seniorDesignMAY1607/pcb_HDMI2RGB/README.md

# pcb_HDMI2RGB
KiCad Design files for HDMI to 24Bit RGB converter used to drive DLP3010 TI EVM board.
