seniorDesignMAY1607/pcb_HDMI2RGB/HDMI2RGB_BOM.ods

Reference | Value | Part # | Quantity | Cost | Total | Supplier | Footprint | Link
C1, C15, C16, C17, C18, C19, C2, C22, C24, C29, C3, C30, C31, C34, C35, C4, C5, C6 | 0.1uF | 0402YD104KAT2A | 21 | 0.1 | 2.1 | Mouser | Capacitors_SMD:C_0402 | http://www.mouser.com/ProductDetail/AVX/0402YD104KAT2A/?qs=sGAEpiMZZMs0AnBnWHyRQOGP6fEKn1FCc5icYNsTrcI%3d
C13, C14 | 18pF | 06035A180JAT2A | 2 | 0.1 | 0.2 | Mouser | Capacitors_SMD:C_0603 | http://www.mouser.com/ProductDetail/AVX/06035A180JAT2A/
J1 | HDMI_A | 10029449-111RLF | 1 | 0.73 | 0.73 | Mouser | hdmi:FCI_10029449-11[13]RLF | http://www.mouser.com/ProductDetail/FCI/10029449-111RLF/
SW1 | 2M1-SP1-T2-B4-M6RE | 2M1-SP1-T2-B4-M6RE | 1 |  | 0 |  | misc:2M1-SP1-T2-B4-M6RE
U3 | ABM3B-24.000MHZ-B2-T | ABM3B-24.000MHZ-B2-T | 1 | 1.14 | 1.14 | Mouser | SMD_Packages:XTAL_ABRACON | http://www.mouser.com/ProductDetail/ABRACON/ABM3B-24000MHZ-B2-T/
U5 | ADV7611 | ADV7611BSWZ-P | 1 | 14.21 | 14.21 | Mouser | misc:LQFP-64_TH_10x10mm_Pitch0.5mm | http://www.mouser.com/ProductDetail/Analog-Devices/ADV7611BSWZ-P/?qs=sGAEpiMZZMv9Q1JI0Mo%2ftQPxLbY1tPB%252b
FB1, FB2, FB3, FB4, FB5 | FILTER | BLM18AG601SN1D | 5 | 0.1 | 0.5 | Mouser | Capacitors_SMD:C_0603 | http://www.mouser.com/ProductDetail/Murata-Electronics/BLM18AG601SN1D/?qs=eh6oC%2F9l24oGGaJFkAJJAA%3D%3D
C10, C11, C12, C20, C21, C23, C25, C26, C27, C28, C7, C8, C9 | 10nF | C0402C103K5RACTU | 13 | 0.1 | 1.3 | Mouser | Capacitors_SMD:C_0402 | www.mouser.com/ProductDetail/Kemet/C0402C103K5RACTU/?qs=sGAEpiMZZMs0AnBnWHyRQHHMgvpwHSjWWgw8Y4tWtxo%3d
C36, C37, C40, C41 | 10uF | C0805C106K4PACTU | 4 | 0.29 | 1.16 | Mouser | Capacitors_SMD:C_0805 | http://www.mouser.com/ProductDetail/Kemet/C0805C106K4PACTU/
C38, C39 | 4.7uF | C0805C475K8PACTU | 2 | 0.28 | 0.56 | Mouser | Capacitors_SMD:C_0805 | http://www.mouser.com/ProductDetail/Kemet/C0805C475K8PACTU/?qs=sGAEpiMZZMs0AnBnWHyRQDHs3SeBlWSBNMCXxRDVnHA%3d
R29, R30 | 150k | CRCW0402150KFKED | 2 | 0.1 | 0.2 | Mouser | Resistors_SMD:R_0603 | http://www.mouser.com/ProductDetail/Vishay-Dale/CRCW0402150KFKED/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
R24, R25, R26, R28, R31,R34 | 270 | CRCW0402270RFKED | 6 | 0.1 | 0.6 | Mouser | Resistors_SMD:R_0402 | http://www.mouser.com/ProductDetail/Vishay-Dale/CRCW0402270RFKED/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
R10, R8, R9 | 33 | CRCW040233R0FKED | 3 | 0.1 | 0.3 | Mouser | Capacitors_SMD:C_0402 | http://www.mouser.com/ProductDetail/Vishay-Dale/CRCW040233R0FKED/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
R1, R11, R15, R16, R2, R6 | 0 | CRCW06030000Z0EA | 6 | 0.1 | 0.6 | Mouser | Resistors_SMD:R_0402 | http://www.mouser.com/ProductDetail/Vishay-Dale/CRCW06030000Z0EA/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
R27 | 200 | CRCW0805200RFKEA | 1 | 0.1 | 0.1 | Mouser | Resistors_SMD:R_0805 | http://www.mouser.com/ProductDetail/Vishay-Dale/CRCW0805200RFKEA/
R12, R13, R14, R17, R18, R19, R20, R21, R22, R23, R3, R4, R5, R7 | 4.7k | ERJ-2GEJ472X | 14 | 0.1 | 1.4 | Digikey | Resistors_SMD:R_0402 | http://www.digikey.com/product-detail/en/panasonic-electronic-components/ERJ-2GEJ472X/P4.7KJCT-ND/147025
R33 | 680k | ERJ-2GEJ684X | 1 | 0.1 | 0.1 | Mouser | Resistors_SMD:R_0603 | http://www.mouser.com/ProductDetail/Panasonic/ERJ-2GEJ684X/
R32 | 300k | ERJ-2RKF3003X | 1 | 0.21 | 0.21 | Mouser | Resistors_SMD:R_0603 | http://www.mouser.com/ProductDetail/Panasonic/ERJ-2RKF3003X/
L1, L2 | 2.2uH | LQM31PN2R2M00L | 2 | 0.38 | 0.76 | Mouser | Capacitors_SMD:C_1206 | http://www.mouser.com/ProductDetail/Murata/LQM31PN2R2M00L/
D1, D2, D3, D4, D5, D6 | LED | LTST-C190KGKT | 6 | 0.28 | 1.68 | Mouser | Capacitors_SMD:C_0603 | http://www.mouser.com/ProductDetail/Lite-On/LTST-C190KGKT/
U6 | MSP430F2274TRHAR | MSP430F2274TRHAT | 1 | 6.48 | 6.48 | Mouser | Housings_DFN_QFN:QFN-40-1EP_6x6mm_Pitch0.5mm | http://www.mouser.com/ProductDetail/Texas-Instruments/MSP430F2274TRHAT/
J2 | QTH-030-02-L-DA | QTH-030-L-D-A | 1 | 9.88 | 9.88 | Digikey | QTH_030_02:QTH-030-02-L-D-A | http://www.digikey.com/product-detail/en/samtec-inc/QTH-030-02-L-D-A/SAM8186-ND/1106530
J3 | RAPC712x | RAPC712X | 1 |  | 0 |  | misc:RAPC712
U12, U13, U7, U9 | SN74AUP1G06DCKR | SN74AUP1G06DCKR | 4 |  | 0 |  | TO_SOT_Packages_SMD:SC-70-5
U8 | SN74AUP1G07DCKR | SN74AUP1G07DCKR | 1 |  | 0 |  | TO_SOT_Packages_SMD:SC-70-5
U1, U2 | TPD4S010DQAR | TPD4S010DQAR | 2 | 0.66 | 1.32 | Mouser | misc:10-USON | http://www.mouser.com/ProductDetail/Texas-Instruments/TPD4S010DQAR/
U4 | TPS2061 | TPS2061CDBVT | 1 | 1.48 | 1.48 |  | TO_SOT_Packages_SMD:SOT-23-5 | http://www.mouser.com/ProductDetail/Texas-Instruments/TPS2061CDBVT/
U10, U11 | TPS62260 | TPS62260DRVT | 2 | 1.8 | 3.6 | Mouser | misc:WSON-6 | http://www.mouser.com/ProductDetail/Texas-Instruments/TPS62260DRVT/?qs=sGAEpiMZZMv2US1BCAiByzAvHxVUKNX4
RP1, RP2, RP3 | R_PACK8 | YC248-JR-0733RL | 3 | 0.31 | 0.93 | Mouser | rpack:RPACK-8_0616 | http://www.mouser.com/ProductDetail/Yageo/YC248-JR-0733RL/
H1, H2, H3 | HOLE1 |  | 3 |  | 0 |  | Mounting_Holes:MountingHole_4.3mm_M4_Pad
P1 | CONN_02X07 |  | 1 |  | 0 |  | Connect:IDC_Header_Straight_14pins
P2, P3 | CONN_01X06 |  | 2 |  | 0 |  | Pin_Headers:Pin_Header_Straight_1x06
 |  |  |  |  | 51.54
