seniorDesignMAY1607/pcb_HDMI2RGB/HDMI2RGB.pdf

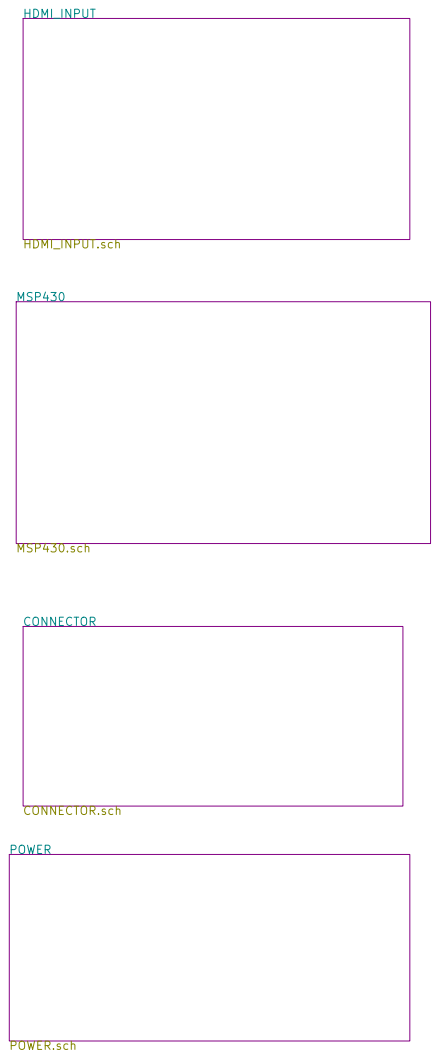
[picture p1: page 1]

IOWA STATE UNIVERSITY - SENIOR DESIGN MAY1607
File: HDMI2RGB.sch Sheet: /
Id: 1/5 Title: PROJECT HIEARCHY

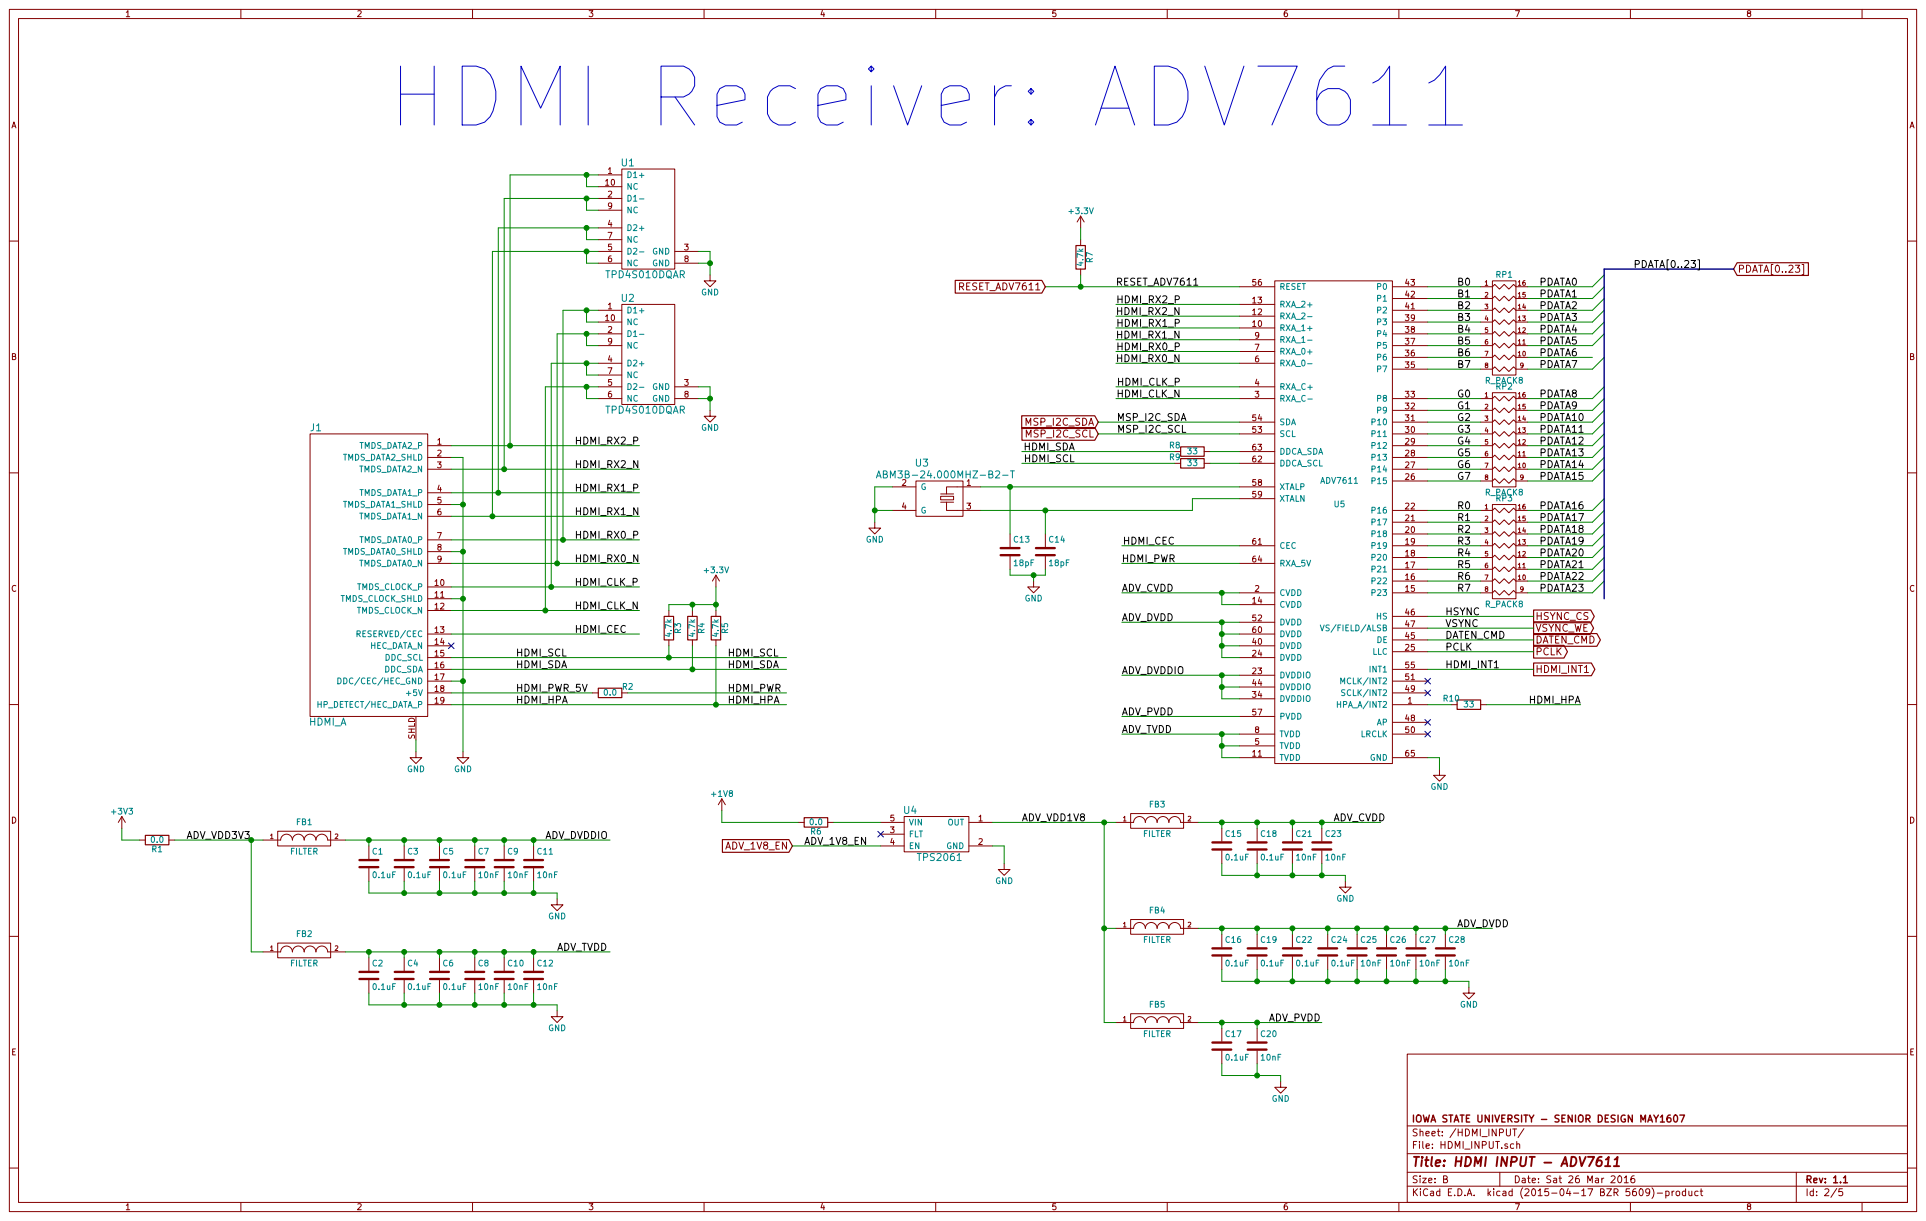
[picture p2: page 2]

HDMI_RX2_N
HDMI_RX1_P
HDMI_RX1_N
HDMI_RX0_P
HDMI_RX0_N

IOWA STATE UNIVERSITY - SENIOR DESIGN MAY1607
Sheet: /HDMI_INPUT/
File: HDMI_INPUT.sch
Id: 2/5 Title: HDMI INPUT - ADV7611

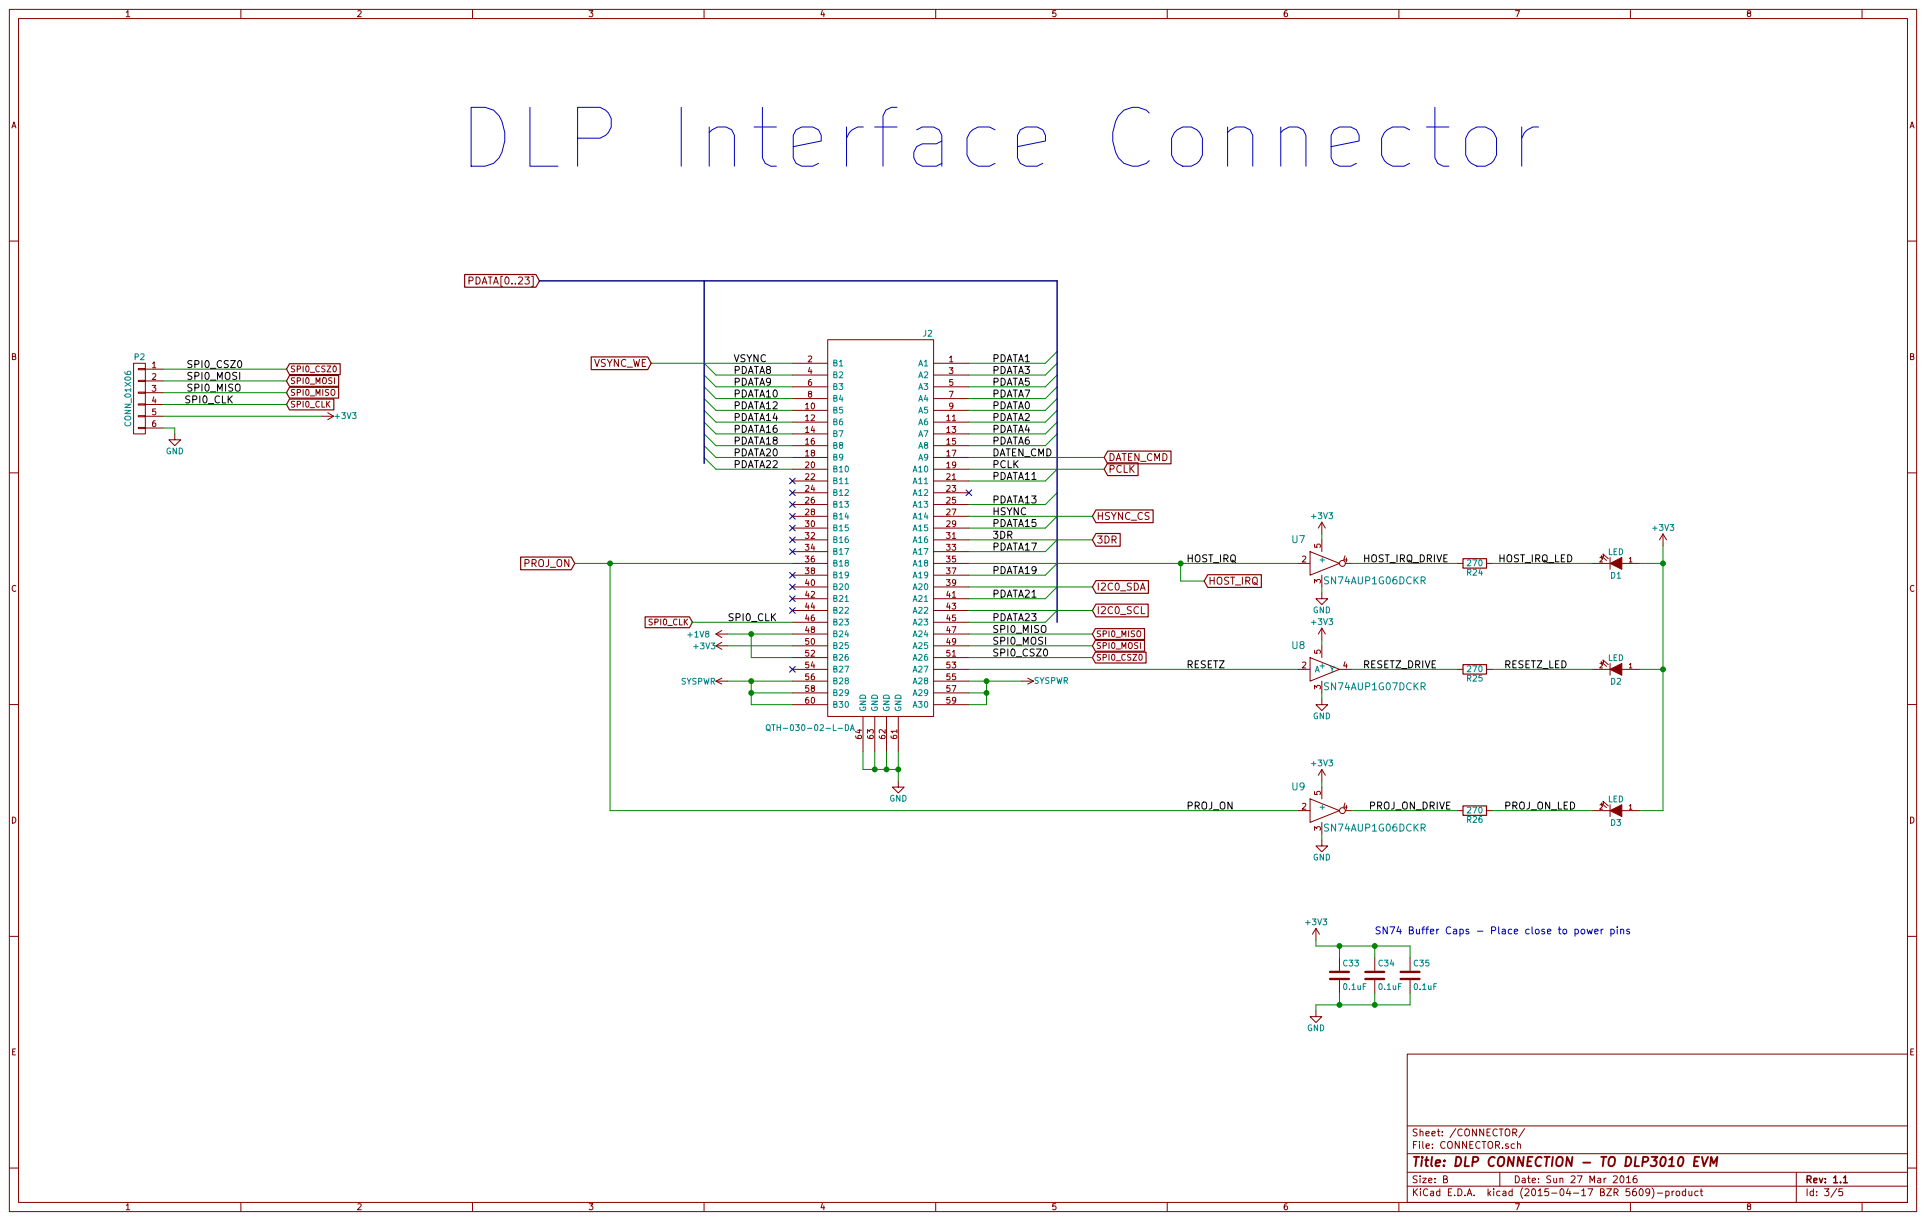
[picture p3: page 3]

0.1uF SN74 Buffer Caps - Place close to power pins

File: CONNECTOR.sch Sheet: /CONNECTOR/
Id: 3/5 Title: DLP CONNECTION - TO DLP3010 EVM

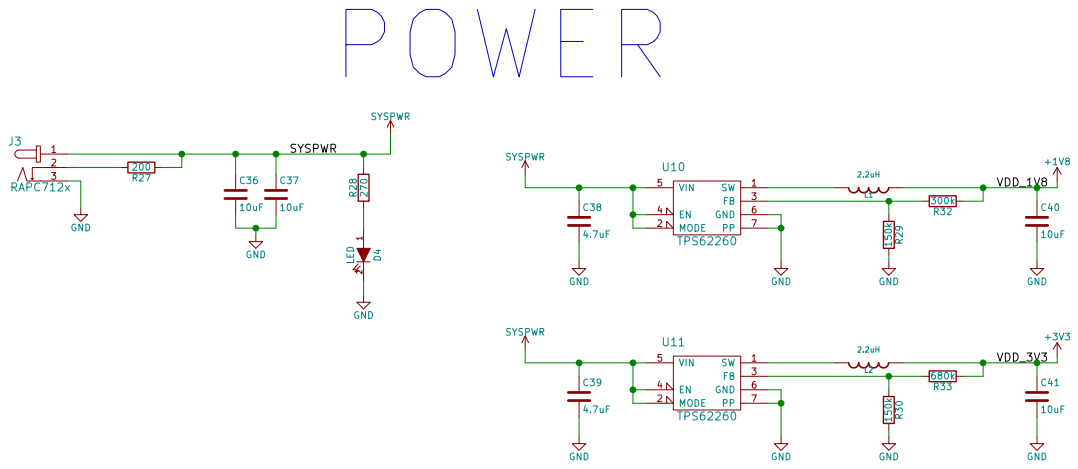
[picture p4: page 4]

Id: 4/5 Title: File: POWER.sch Sheet: /POWER/

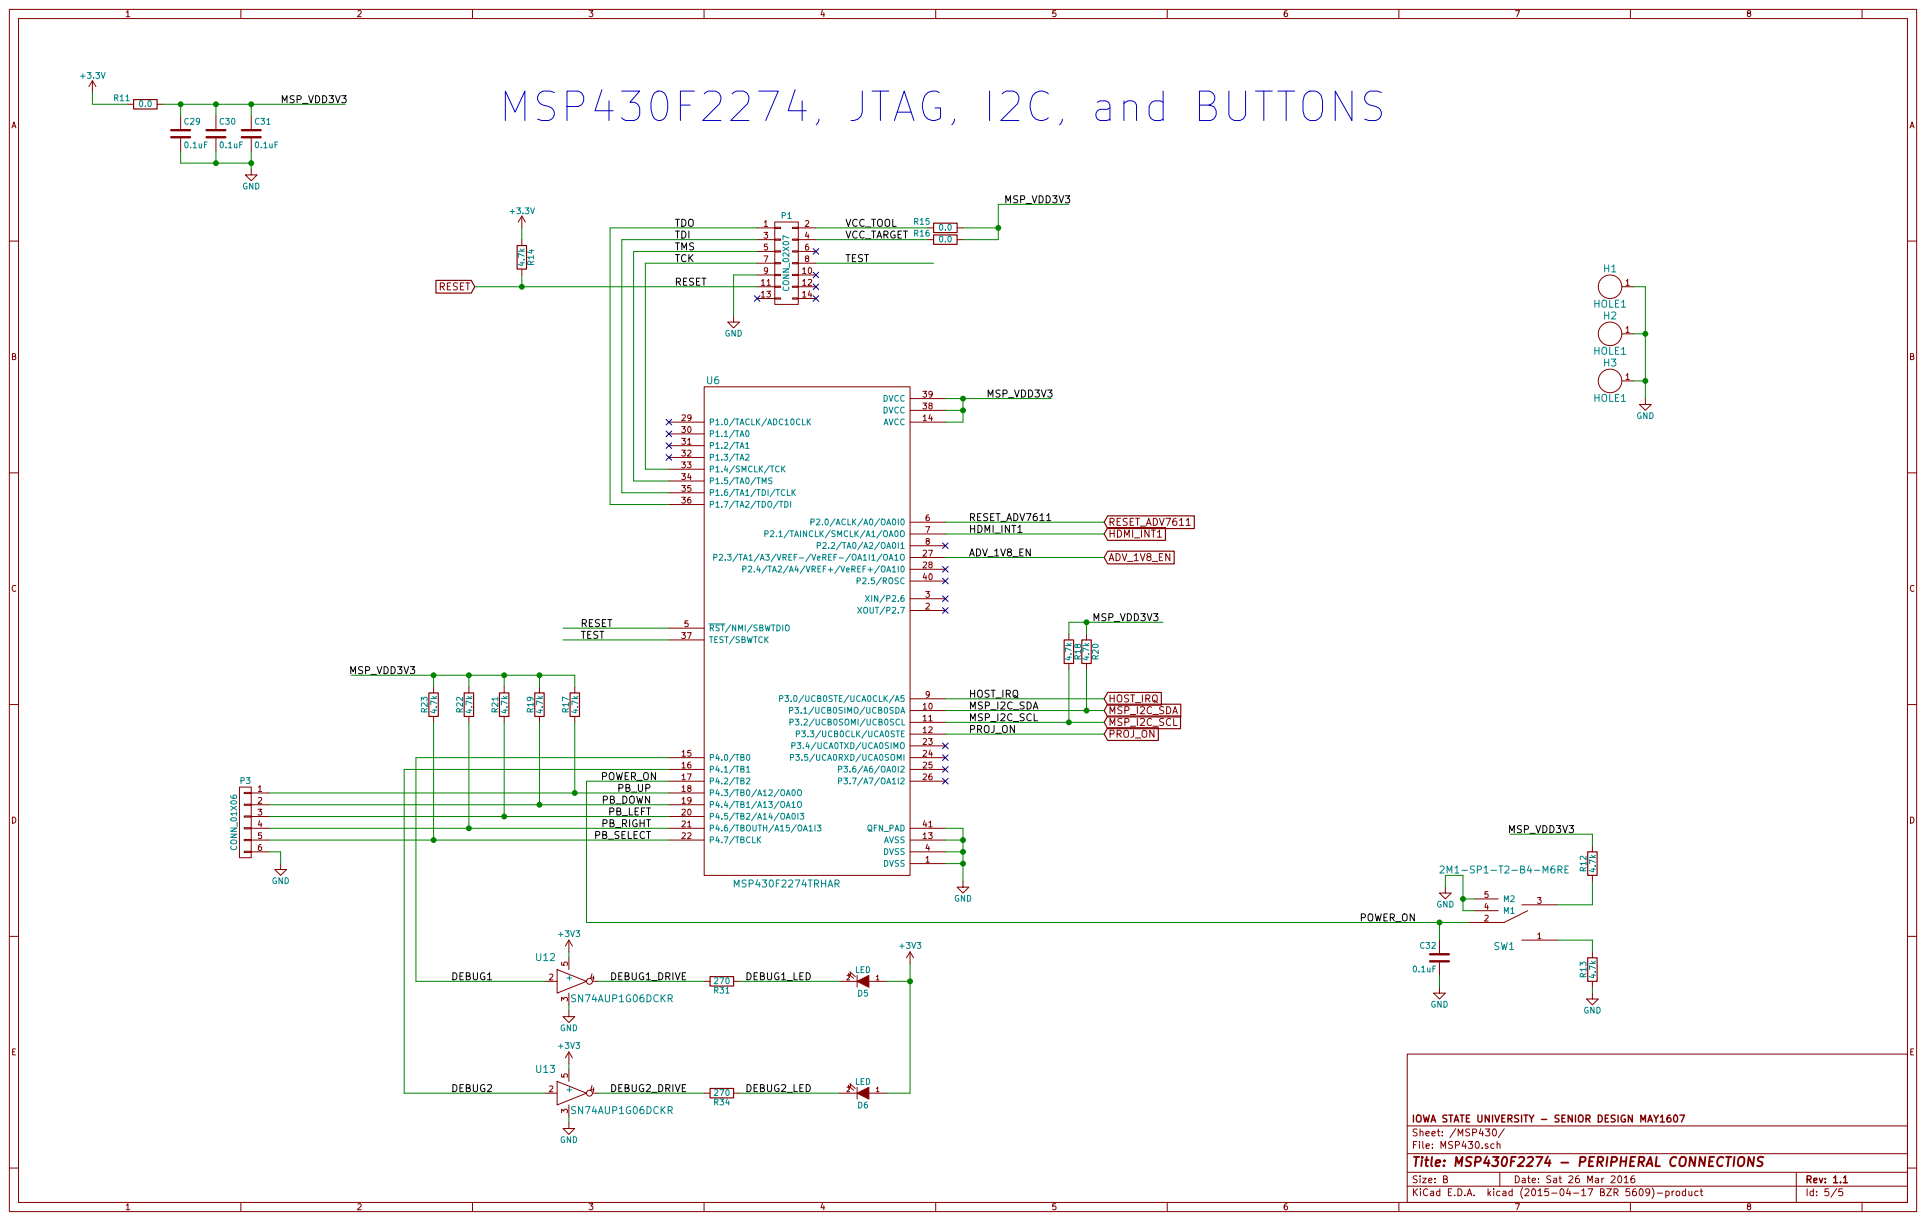
[picture p5: page 5]

2 | | | | PB_DOWN
3 | | | PB_LEFT
4 | | PB_RIGHT
5 | PB_SELECT

IOWA STATE UNIVERSITY - SENIOR DESIGN MAY1607
File: MSP430.sch Sheet: /MSP430/
Id: 5/5 Title: MSP430F2274 - PERIPHERAL CONNECTIONS
