seniorDesignMAY1607/pcb_HDMI2RGB/HDMI2RGB.kicad_pcb

## KiCad design HDMI2RGB.kicad_pcb (2016-03-31)

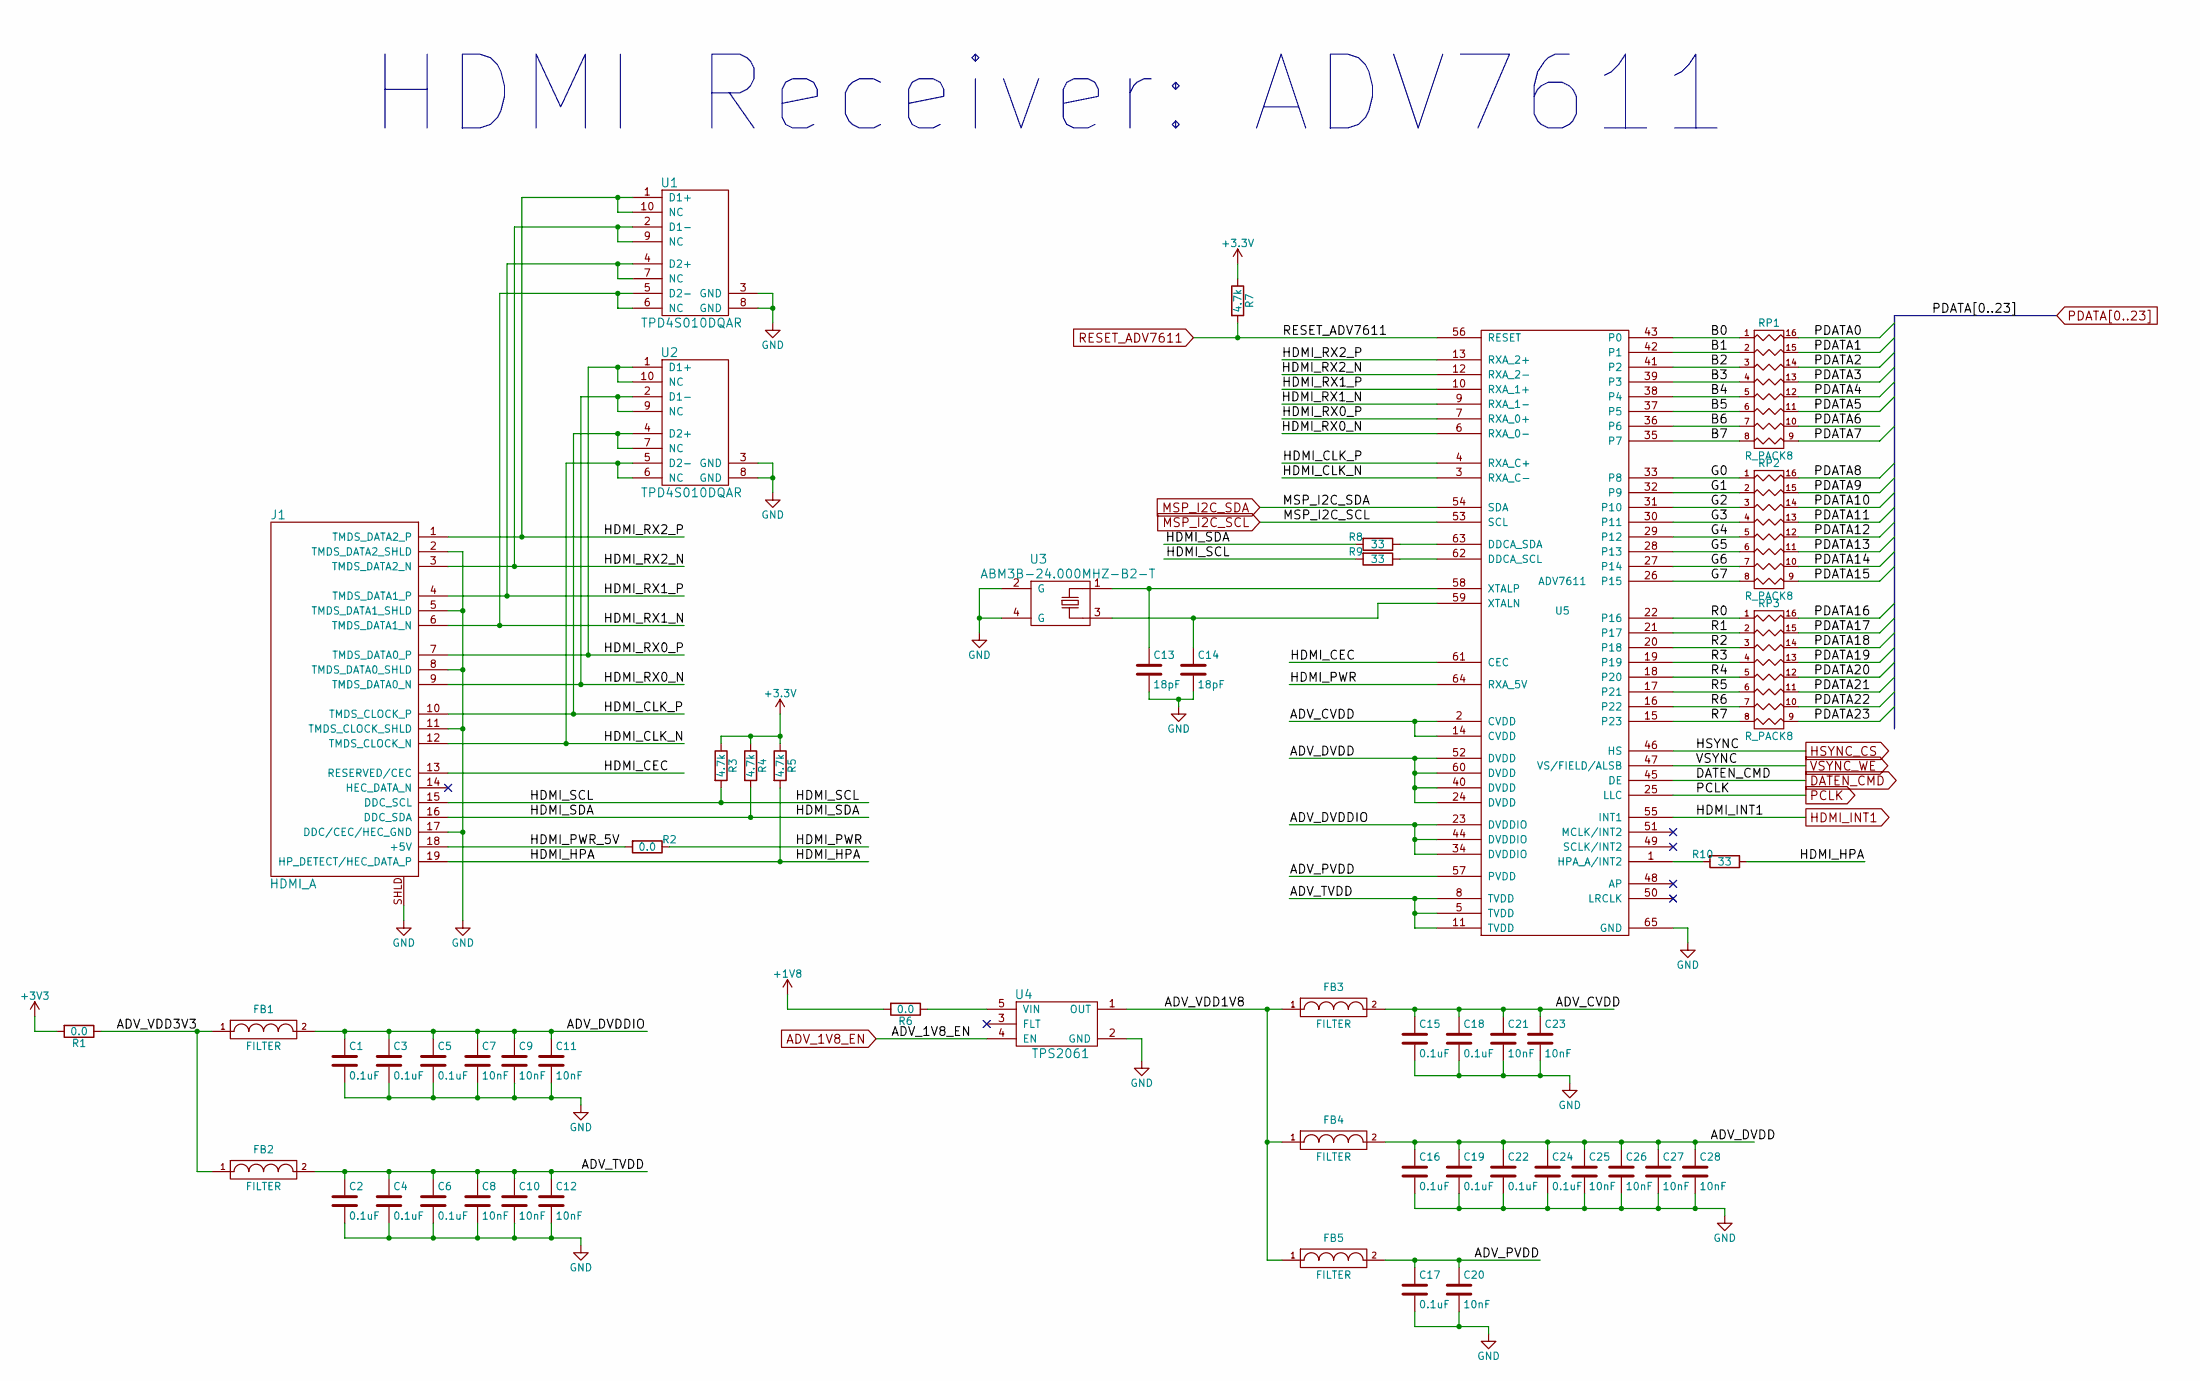
[picture p6: schematic HDMI_INPUT.sch, HDMI INPUT - ADV7611]

Parts:
C1, C2, C3, C4, C5, C6, C15, C16, C17, C18, C19, C22, C24: 0.1uF; C_0402; Part # 0402YD104KAT2A
C7, C8, C9, C10, C11, C12, C20, C21, C23, C25, C26, C27, C28: 10nF; C_0402; Part # C0402C103K5RACTU
C13, C14: 18pF; C_0603; Part # 06035A180JAT2A
FB1, FB2, FB3, FB4, FB5: FILTER; C_0603; Part # BLM18AG601SN1D
J1: HDMI_A; FCI_10029449-11[13]RLF
R1, R2, R6: 0.0; R_0402; Part # CRCW06030000Z0EA
R3, R4, R5, R7: 4.7k; R_0402; Part # ERJ-2GEJ472X
R8, R9: 33; R_0402; Part # CRCW040233R0FKED
R10: 33; C_0402; Part # CRCW040233R0FKED
RP1, RP2, RP3: R_PACK8; RPACK-8_0616
U1, U2: TPD4S010DQAR; 10-USON
U3: ABM3B-24.000MHZ-B2-T; XTAL_ABRACON; Part # ABM3B-24.000MHZ-B2-T
U4: TPS2061; SOT-23-5; Part # TPS2061CDBVT
U5: ADV7611; LQFP-64_TH_10x10mm_Pitch0.5mm

Connections:
+1V8: R6.2; also elsewhere on the board
/CONNECTOR/PDATA0: RP1.16 (R1); also elsewhere on the board
/CONNECTOR/PDATA1: RP1.15 (R2); also elsewhere on the board
/CONNECTOR/PDATA2: RP1.14 (R3); also elsewhere on the board
/CONNECTOR/PDATA3: RP1.13 (R4); also elsewhere on the board
/CONNECTOR/PDATA4: RP1.12 (R5); also elsewhere on the board
/CONNECTOR/PDATA5: RP1.11 (R6); also elsewhere on the board
/CONNECTOR/PDATA6: RP1.10 (R7); also elsewhere on the board
/CONNECTOR/PDATA7: RP1.9 (R8); also elsewhere on the board
/CONNECTOR/PDATA8: RP2.16 (R1); also elsewhere on the board
/CONNECTOR/PDATA9: RP2.15 (R2); also elsewhere on the board
/CONNECTOR/PDATA10: RP2.14 (R3); also elsewhere on the board
/CONNECTOR/PDATA11: RP2.13 (R4); also elsewhere on the board
/CONNECTOR/PDATA12: RP2.12 (R5); also elsewhere on the board
/CONNECTOR/PDATA13: RP2.11 (R6); also elsewhere on the board
/CONNECTOR/PDATA14: RP2.10 (R7); also elsewhere on the board
/CONNECTOR/PDATA15: RP2.9 (R8); also elsewhere on the board
/CONNECTOR/PDATA16: RP3.16 (R1); also elsewhere on the board
/CONNECTOR/PDATA17: RP3.15 (R2); also elsewhere on the board
/CONNECTOR/PDATA18: RP3.14 (R3); also elsewhere on the board
/CONNECTOR/PDATA19: RP3.13 (R4); also elsewhere on the board
/CONNECTOR/PDATA20: RP3.12 (R5); also elsewhere on the board
/CONNECTOR/PDATA21: RP3.11 (R6); also elsewhere on the board
/CONNECTOR/PDATA22: RP3.10 (R7); also elsewhere on the board
/CONNECTOR/PDATA23: RP3.9 (R8); also elsewhere on the board
/HDMI_INPUT/ADV_CVDD: C15.1, C18.1, C21.1, C23.1, FB3.2, U5.2 (CVDD), U5.14 (CVDD)
/HDMI_INPUT/ADV_DVDD: C16.1, C19.1, C22.1, C24.1, C25.1, C26.1, C27.1, C28.1, FB4.2, U5.24 (DVDD), U5.40 (DVDD), U5.52 (DVDD), U5.60 (DVDD)
/HDMI_INPUT/ADV_DVDDIO: C1.1, C3.1, C5.1, C7.1, C9.1, C11.1, FB1.2, U5.23 (DVDDIO), U5.34 (DVDDIO), U5.44 (DVDDIO)
/HDMI_INPUT/ADV_PVDD: C17.1, C20.1, FB5.2, U5.57 (PVDD)
/HDMI_INPUT/ADV_TVDD: C2.1, C4.1, C6.1, C8.1, C10.1, C12.1, FB2.2, U5.5 (TVDD), U5.8 (TVDD), U5.11 (TVDD)
/HDMI_INPUT/ADV_VDD1V8: FB3.1, FB4.1, FB5.1, U4.1 (OUT)
/HDMI_INPUT/ADV_VDD3V3: FB1.1, FB2.1, R1.1
/HDMI_INPUT/B0: RP1.1, U5.43 (P0)
/HDMI_INPUT/B1: RP1.2, U5.42 (P1)
/HDMI_INPUT/B2: RP1.3, U5.41 (P2)
/HDMI_INPUT/B3: RP1.4, U5.39 (P3)
/HDMI_INPUT/B4: RP1.5, U5.38 (P4)
/HDMI_INPUT/B5: RP1.6, U5.37 (P5)
/HDMI_INPUT/B6: RP1.7, U5.36 (P6)
/HDMI_INPUT/B7: RP1.8, U5.35 (P7)
/HDMI_INPUT/G0: RP2.1, U5.33 (P8)
/HDMI_INPUT/G1: RP2.2, U5.32 (P9)
/HDMI_INPUT/G2: RP2.3, U5.31 (P10)
/HDMI_INPUT/G3: RP2.4, U5.30 (P11)
/HDMI_INPUT/G4: RP2.5, U5.29 (P12)
/HDMI_INPUT/G5: RP2.6, U5.28 (P13)
/HDMI_INPUT/G6: RP2.7, U5.27 (P14)
/HDMI_INPUT/G7: RP2.8, U5.26 (P15)
/HDMI_INPUT/HDMI_CEC: J1.13 (RESERVED/CEC), U5.61 (CEC)
/HDMI_INPUT/HDMI_CLK_N: J1.12 (TMDS_CLOCK_N), U2.5 (D2-), U2.6 (NC), U5.3 (RXA_C-)
/HDMI_INPUT/HDMI_CLK_P: J1.10 (TMDS_CLOCK_P), U2.4 (D2+), U2.7 (NC), U5.4 (RXA_C+)
/HDMI_INPUT/HDMI_HPA: J1.19 (HP_DETECT/HEC_DATA_P), R5.2, R10.1
/HDMI_INPUT/HDMI_PWR: R2.1, U5.64 (RXA_5V)
/HDMI_INPUT/HDMI_PWR_5V: J1.18 (+5V), R2.2
/HDMI_INPUT/HDMI_RX0_N: J1.9 (TMDS_DATA0_N), U2.2 (D1-), U2.9 (NC), U5.6 (RXA_0-)
/HDMI_INPUT/HDMI_RX0_P: J1.7 (TMDS_DATA0_P), U2.1 (D1+), U2.10 (NC), U5.7 (RXA_0+)
/HDMI_INPUT/HDMI_RX1_N: J1.6 (TMDS_DATA1_N), U1.5 (D2-), U1.6 (NC), U5.9 (RXA_1-)
/HDMI_INPUT/HDMI_RX1_P: J1.4 (TMDS_DATA1_P), U1.4 (D2+), U1.7 (NC), U5.10 (RXA_1+)
/HDMI_INPUT/HDMI_RX2_N: J1.3 (TMDS_DATA2_N), U1.2 (D1-), U1.9 (NC), U5.12 (RXA_2-)
/HDMI_INPUT/HDMI_RX2_P: J1.1 (TMDS_DATA2_P), U1.1 (D1+), U1.10 (NC), U5.13 (RXA_2+)
/HDMI_INPUT/HDMI_SCL: J1.15 (DDC_SCL), R3.2, R9.2
/HDMI_INPUT/HDMI_SDA: J1.16 (DDC_SDA), R4.2, R8.2
/HDMI_INPUT/R0: RP3.1, U5.22 (P16)
/HDMI_INPUT/R1: RP3.2, U5.21 (P17)
/HDMI_INPUT/R2: RP3.3, U5.20 (P18)
/HDMI_INPUT/R3: RP3.4, U5.19
/HDMI_INPUT/R4: RP3.5, U5.18 (P20)
/HDMI_INPUT/R5: RP3.6, U5.17 (P21)
/HDMI_INPUT/R6: RP3.7, U5.16 (P22)
/HDMI_INPUT/R7: RP3.8, U5.15 (P23)
ADV_1V8_EN: U4.4 (EN); also elsewhere on the board
DATEN_CMD: U5.45 (DE); also elsewhere on the board
GND: C1.2, C2.2, C3.2, C4.2, C5.2, C6.2, C7.2, C8.2, C9.2, C10.2, C11.2, C12.2, C13.2, C14.2, C15.2, C16.2, C17.2, C18.2, C19.2, C20.2, C21.2, C22.2, C23.2, C24.2, C25.2, C26.2, C27.2, C28.2, J1.2 (TMDS_DATA2_SHLD), J1.5 (TMDS_DATA1_SHLD), J1.8 (TMDS_DATA0_SHLD), J1.11 (TMDS_CLOCK_SHLD), J1.17 (DDC/CEC/HEC_GND), J1.SHLD, U1.3 (GND), U1.8 (GND), U2.3 (GND), U2.8 (GND), U3.2 (G), U3.4 (G), U4.2 (GND), U5.65 (GND); also elsewhere on the board
HDMI_INT1: U5.55 (INT1); also elsewhere on the board
HSYNC_CS: U5.46 (HS); also elsewhere on the board
MSP_I2C_SCL: U5.53 (SCL); also elsewhere on the board
MSP_I2C_SDA: U5.54 (SDA); also elsewhere on the board
unnamed: C13.1, U3.1, U5.58 (XTALP)
unnamed: C14.1, U3.3, U5.59 (XTALN)
unnamed: R6.1, U4.5 (VIN)
unnamed: R8.1, U5.63 (DDCA_SDA)
unnamed: R9.1, U5.62 (DDCA_SCL)
unnamed: R10.2, U5.1 (HPA_A/INT2)
PCLK: U5.25 (LLC); also elsewhere on the board
RESET_ADV7611: R7.2, U5.56 (RESET); also elsewhere on the board
VSYNC_WE: U5.47 (VS/FIELD/ALSB); also elsewhere on the board

Notes on the sheet:
HDMI Receiver: ADV7611

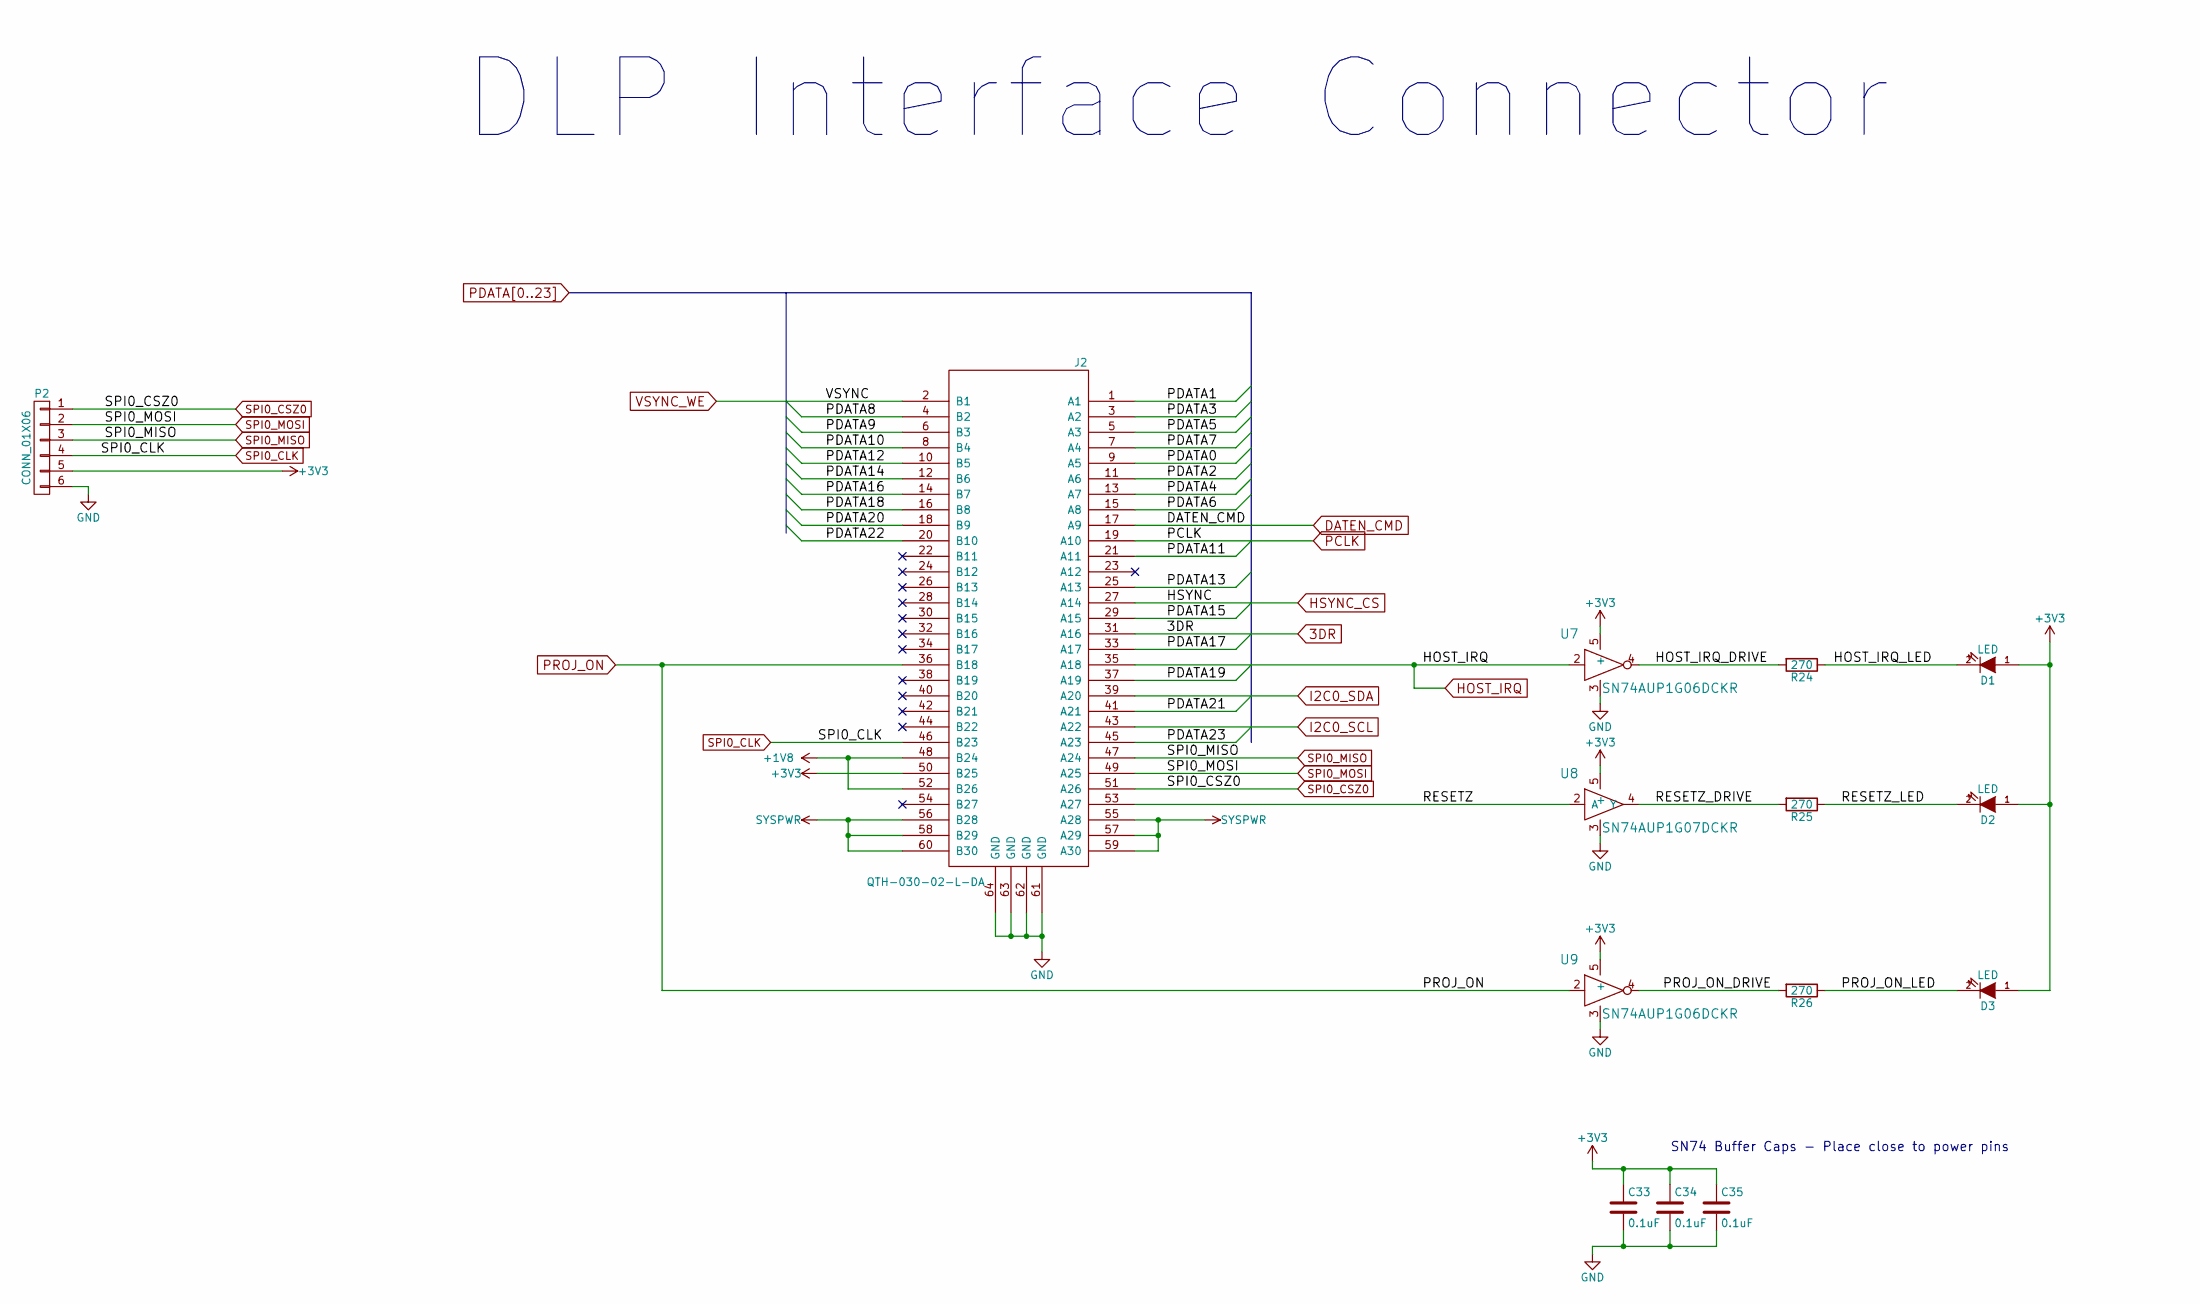
[picture p7: schematic CONNECTOR.sch, DLP CONNECTION - TO DLP3010 EVM]

Parts:
C33, C34, C35: 0.1uF; C_0402; Part # 0402YD104KAT2A
D1, D2, D3: LED; C_0603; Part # LTST-C190KGKT
J2: QTH-030-02-L-DA; QTH-030-02-L-D-A; Part # QTH-030-L-D-A
P2: CONN_01X06; Pin_Header_Straight_1x06
R24, R25, R26: 270; R_0402; Part # CRCW0402270RFKED
U7, U9: SN74AUP1G06DCKR; SC-70-5; Part # SN74AUP1G06DCKR
U8: SN74AUP1G07DCKR; SC-70-5; Part # SN74AUP1G07DCKR

Connections:
3DR: J2.31 (A16)
+1V8: J2.48 (B24), J2.52 (B26); also elsewhere on the board
/CONNECTOR/HOST_IRQ_DRIVE: R24.2, U7.4
/CONNECTOR/HOST_IRQ_LED: D1.2 (K), R24.1
/CONNECTOR/PDATA0: J2.9 (A5); also elsewhere on the board
/CONNECTOR/PDATA1: J2.1 (A1); also elsewhere on the board
/CONNECTOR/PDATA2: J2.11 (A6); also elsewhere on the board
/CONNECTOR/PDATA3: J2.3 (A2); also elsewhere on the board
/CONNECTOR/PDATA4: J2.13 (A7); also elsewhere on the board
/CONNECTOR/PDATA5: J2.5 (A3); also elsewhere on the board
/CONNECTOR/PDATA6: J2.15 (A8); also elsewhere on the board
/CONNECTOR/PDATA7: J2.7 (A4); also elsewhere on the board
/CONNECTOR/PDATA8: J2.4 (B2); also elsewhere on the board
/CONNECTOR/PDATA9: J2.6 (B3); also elsewhere on the board
/CONNECTOR/PDATA10: J2.8 (B4); also elsewhere on the board
/CONNECTOR/PDATA11: J2.21 (A11); also elsewhere on the board
/CONNECTOR/PDATA12: J2.10 (B5); also elsewhere on the board
/CONNECTOR/PDATA13: J2.25 (A13); also elsewhere on the board
/CONNECTOR/PDATA14: J2.12 (B6); also elsewhere on the board
/CONNECTOR/PDATA15: J2.29 (A15); also elsewhere on the board
/CONNECTOR/PDATA16: J2.14 (B7); also elsewhere on the board
/CONNECTOR/PDATA17: J2.33 (A17); also elsewhere on the board
/CONNECTOR/PDATA18: J2.16 (B8); also elsewhere on the board
/CONNECTOR/PDATA19: J2.37 (A19); also elsewhere on the board
/CONNECTOR/PDATA20: J2.18 (B9); also elsewhere on the board
/CONNECTOR/PDATA21: J2.41 (A21); also elsewhere on the board
/CONNECTOR/PDATA22: J2.20 (B10); also elsewhere on the board
/CONNECTOR/PDATA23: J2.45 (A23); also elsewhere on the board
/CONNECTOR/PROJ_ON_DRIVE: R26.2, U9.4
/CONNECTOR/PROJ_ON_LED: D3.2 (K), R26.1
/CONNECTOR/RESETZ: J2.53 (A27), U8.2 (A)
/CONNECTOR/RESETZ_DRIVE: R25.2, U8.4 (Y)
/CONNECTOR/RESETZ_LED: D2.2 (K), R25.1
DATEN_CMD: J2.17 (A9); also elsewhere on the board
GND: C33.2, C34.2, C35.2, J2.61 (GND), J2.62 (GND), J2.63 (GND), J2.64 (GND), P2.6, U7.3, U8.3, U9.3; also elsewhere on the board
HOST_IRQ: J2.35 (A18), U7.2; also elsewhere on the board
HSYNC_CS: J2.27 (A14); also elsewhere on the board
I2C0_SCL: J2.43 (A22)
I2C0_SDA: J2.39 (A20)
PCLK: J2.19 (A10); also elsewhere on the board
PROJ_ON: J2.36 (B18), U9.2; also elsewhere on the board
SPI0_CLK: J2.46 (B23), P2.4
SPI0_CSZ0: J2.51 (A26), P2.1
SPI0_MISO: J2.47 (A24), P2.3
SPI0_MOSI: J2.49 (A25), P2.2
SYSPWR: J2.55 (A28), J2.56 (B28), J2.57 (A29), J2.58 (B29), J2.59 (A30), J2.60 (B30); also elsewhere on the board
VSYNC_WE: J2.2 (B1); also elsewhere on the board

Notes on the sheet:
SN74 Buffer Caps - Place close to power pins
DLP Interface Connector

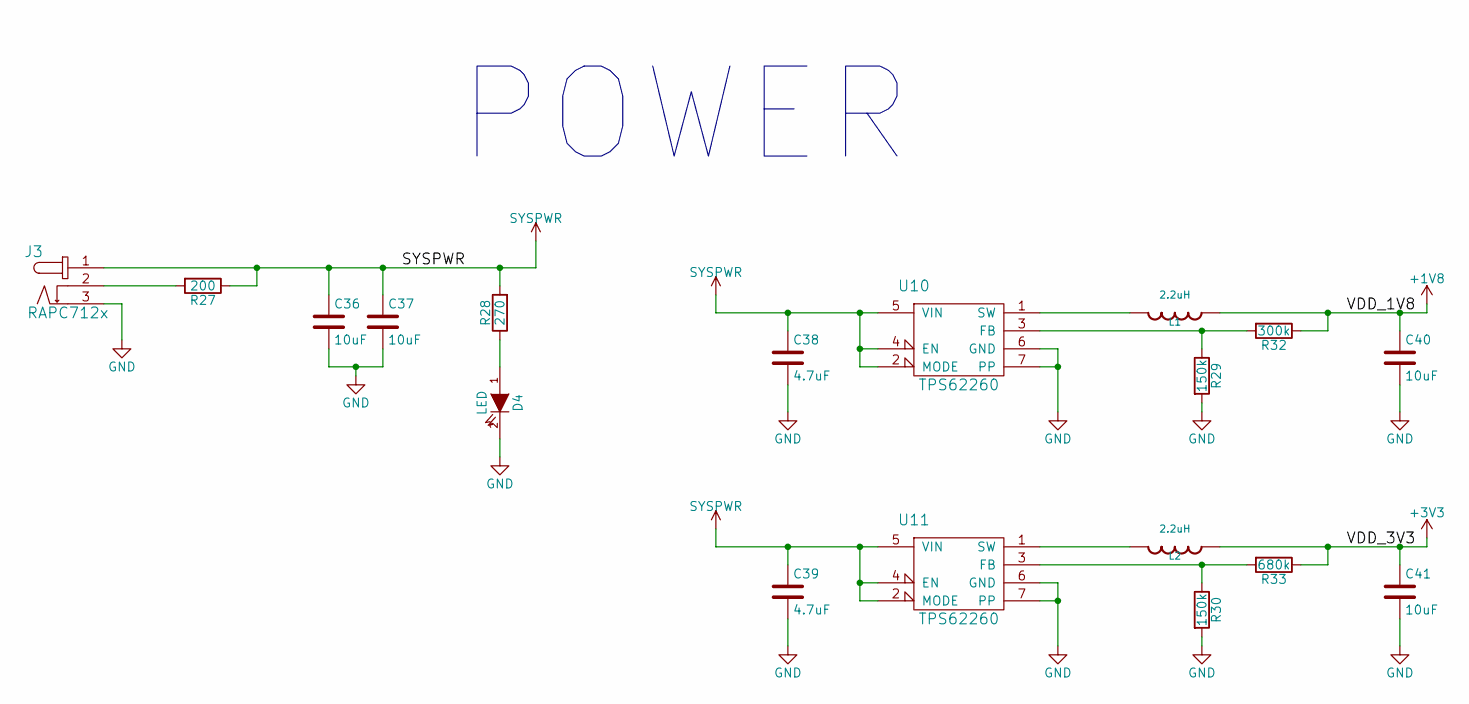
[picture p8: schematic POWER.sch]

Parts:
C36, C37, C40, C41: 10uF; C_0805; Part # C0805C106K4PACTU
C38, C39: 4.7uF; C_0805; Part # C0805C475K8PACTU
D4: LED; C_0603; Part # LTST-C190KGKT
J3: RAPC712x; RAPC712; Part # RAPC712X
L1, L2: 2.2uH; C_1206; Part # LQM31PN2R2M00L
R27: 200; R_0805; Part # CRCW0805200RFKEA
R28: 270; R_0603; Part # CRCW0402270RFKED
R29, R30: 150k; R_0603; Part # CRCW0402150KFKED
R32: 300k; R_0603; Part # ERJ-2RKF3003X
R33: 680k; R_0603; Part # ERJ-2GEJ684X
U10, U11: TPS62260; WSON-6; Part # TPS62260DRVT

Connections:
+1V8: C40.1, L1.2, R32.1; also elsewhere on the board
GND: C36.2, C37.2, C38.2, C39.2, C40.2, C41.2, D4.2 (K), J3.3, R29.2, R30.2, U10.6 (GND), U10.7 (PP), U11.6 (GND), U11.7 (PP); also elsewhere on the board
unnamed: D4.1 (A), R28.1
unnamed: J3.2, R27.2
unnamed: L1.1, U10.1 (SW)
unnamed: L2.1, U11.1 (SW)
unnamed: R29.1, R32.2, U10.3 (FB)
unnamed: R30.1, R33.2, U11.3 (FB)
SYSPWR: C36.1, C37.1, C38.1, C39.1, J3.1, R27.1, R28.2, U10.2 (MODE), U10.4 (EN), U10.5 (VIN), U11.2 (MODE), U11.4 (EN), U11.5 (VIN); also elsewhere on the board

Notes on the sheet:
POWER

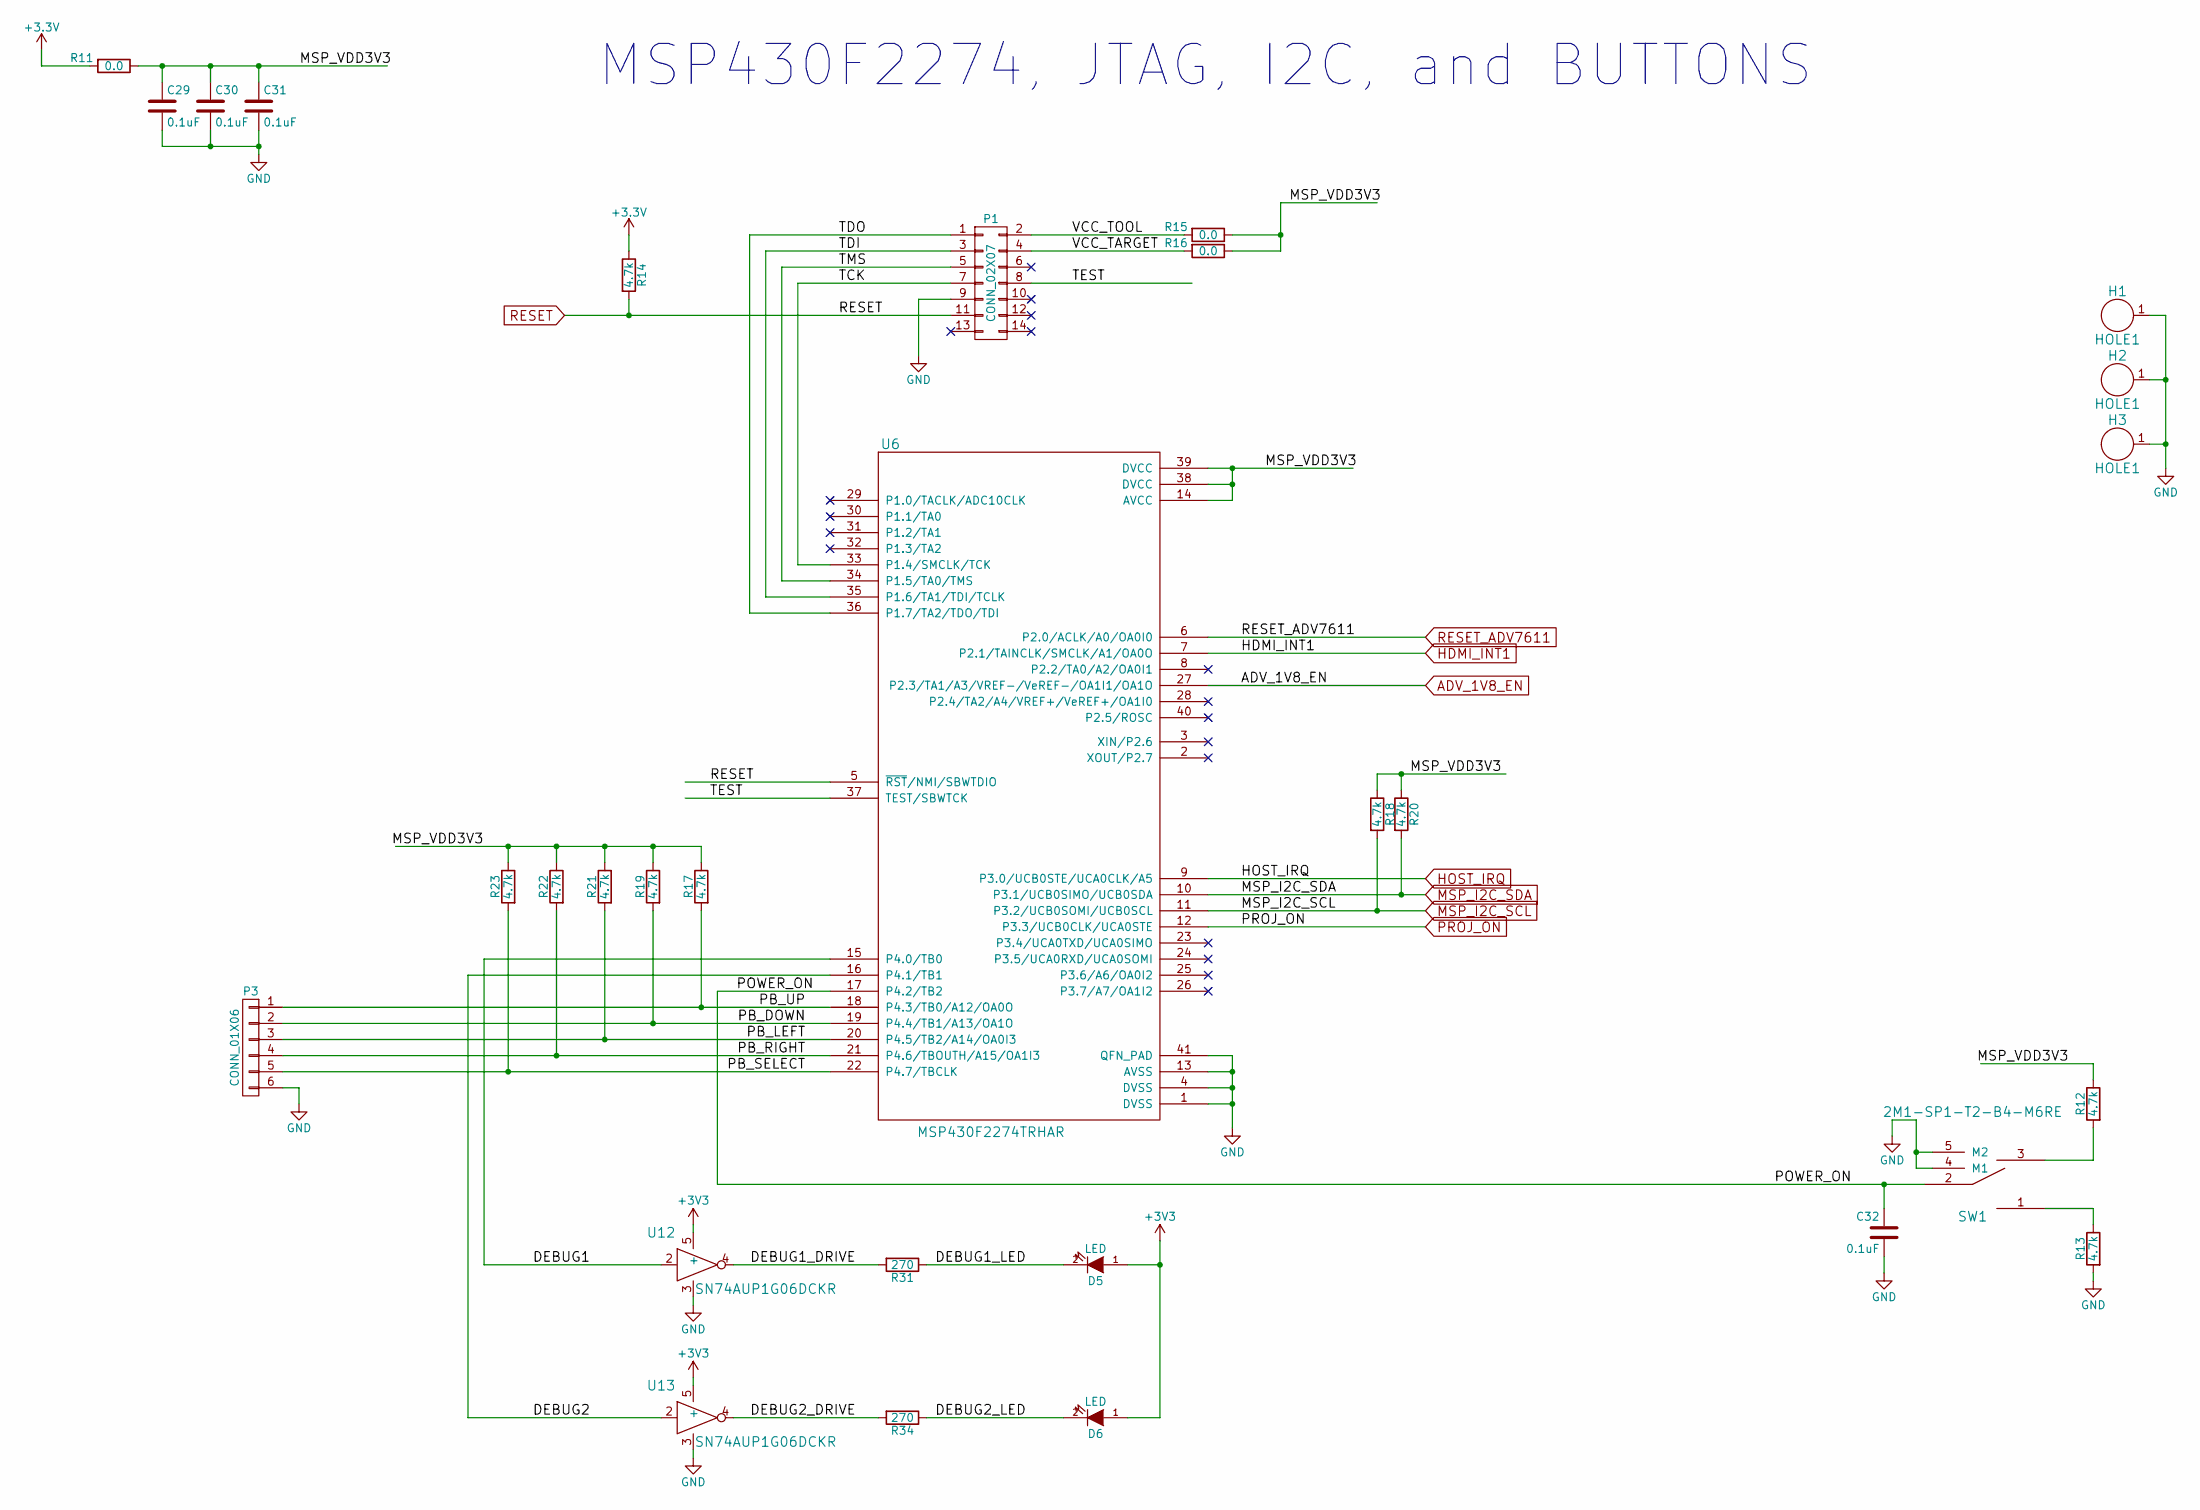
[picture p9: schematic MSP430.sch, MSP430F2274 - PERIPHERAL CONNECTIONS]

Parts:
C29, C30, C31, C32: 0.1uF; C_0402; Part # 0402YD104KAT2A
D5, D6: LED; C_0603; Part # LTST-C190KGKT
H1, H2, H3: HOLE1; MountingHole_4.3mm_M4_Pad
P1: CONN_02X07; IDC_Header_Straight_14pins
P3: CONN_01X06; Pin_Header_Straight_1x06
R11, R15, R16: 0.0; R_0402; Part # CRCW06030000Z0EA
R12, R13, R14, R17, R18, R19, R20, R21, R22, R23: 4.7k; R_0402; Part # ERJ-2GEJ472X
R31, R34: 270; R_0402; Part # CRCW0402270RFKED
SW1: 2M1-SP1-T2-B4-M6RE; Part # 2M1-SP1-T2-B4-M6RE
U6: MSP430F2274TRHAR; QFN-40-1EP_6x6mm_Pitch0.5mm
U12, U13: SN74AUP1G06DCKR; SC-70-5; Part # SN74AUP1G06DCKR

Connections:
/MSP430/DEBUG1: U6.15 (P4.0/TB0), U12.2
/MSP430/DEBUG1_DRIVE: R31.2, U12.4
/MSP430/DEBUG1_LED: D5.2 (K), R31.1
/MSP430/DEBUG2: U6.16 (P4.1/TB1), U13.2
/MSP430/DEBUG2_DRIVE: R34.2, U13.4
/MSP430/DEBUG2_LED: D6.2 (K), R34.1
/MSP430/MSP_VDD3V3: C29.1, C30.1, C31.1, R11.1, R12.1, R15.1, R16.1, R17.1, R18.1, R19.1, R20.1, R21.1, R22.1, R23.1, U6.14 (AVCC), U6.38 (DVCC), U6.39 (DVCC)
/MSP430/PB_DOWN: P3.2, R19.2, U6.19 (P4.4/TB1/A13/OA1O)
/MSP430/PB_LEFT: P3.3, R21.2, U6.20 (P4.5/TB2/A14/OA0I3)
/MSP430/PB_RIGHT: P3.4, R22.2, U6.21 (P4.6/TBOUTH/A15/OA1I3)
/MSP430/PB_SELECT: P3.5, R23.2, U6.22 (P4.7/TBCLK)
/MSP430/PB_UP: P3.1, R17.2, U6.18 (P4.3/TB0/A12/OA0O)
/MSP430/POWER_ON: C32.1, SW1.2, U6.17 (P4.2/TB2)
/MSP430/TCK: P1.7, U6.33 (P1.4/SMCLK/TCK)
/MSP430/TDI: P1.3, U6.35 (P1.6/TA1/TDI/TCLK)
/MSP430/TDO: P1.1, U6.36 (P1.7/TA2/TDO/TDI)
/MSP430/TEST: P1.8, U6.37 (TEST/SBWTCK)
/MSP430/TMS: P1.5, U6.34 (P1.5/TA0/TMS)
/MSP430/VCC_TARGET: P1.4, R16.2
/MSP430/VCC_TOOL: P1.2, R15.2
ADV_1V8_EN: U6.27 (P2.3/TA1/A3/VREF-/VeREF-/OA1I1/OA1O); also elsewhere on the board
GND: C29.2, C30.2, C31.2, C32.2, H1.1, H2.1, H3.1, P1.9, P3.6, R13.2, SW1.4 (M1), SW1.5 (M2), U6.1 (DVSS), U6.4 (DVSS), U6.13 (AVSS), U6.41 (QFN_PAD), U12.3, U13.3; also elsewhere on the board
HDMI_INT1: U6.7 (P2.1/TAINCLK/SMCLK/A1/OA0O); also elsewhere on the board
HOST_IRQ: U6.9 (P3.0/UCB0STE/UCA0CLK/A5); also elsewhere on the board
MSP_I2C_SCL: R18.2, U6.11 (P3.2/UCB0SOMI/UCB0SCL); also elsewhere on the board
MSP_I2C_SDA: R20.2, U6.10 (P3.1/UCB0SIMO/UCB0SDA); also elsewhere on the board
unnamed: R12.2, SW1.3
unnamed: R13.1, SW1.1
PROJ_ON: U6.12 (P3.3/UCB0CLK/UCA0STE); also elsewhere on the board
RESET: P1.11, R14.2, U6.5 (~RST~/NMI/SBWTDIO)
RESET_ADV7611: U6.6 (P2.0/ACLK/A0/OA0I0); also elsewhere on the board

Notes on the sheet:
MSP430F2274, JTAG, I2C, and BUTTONS

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
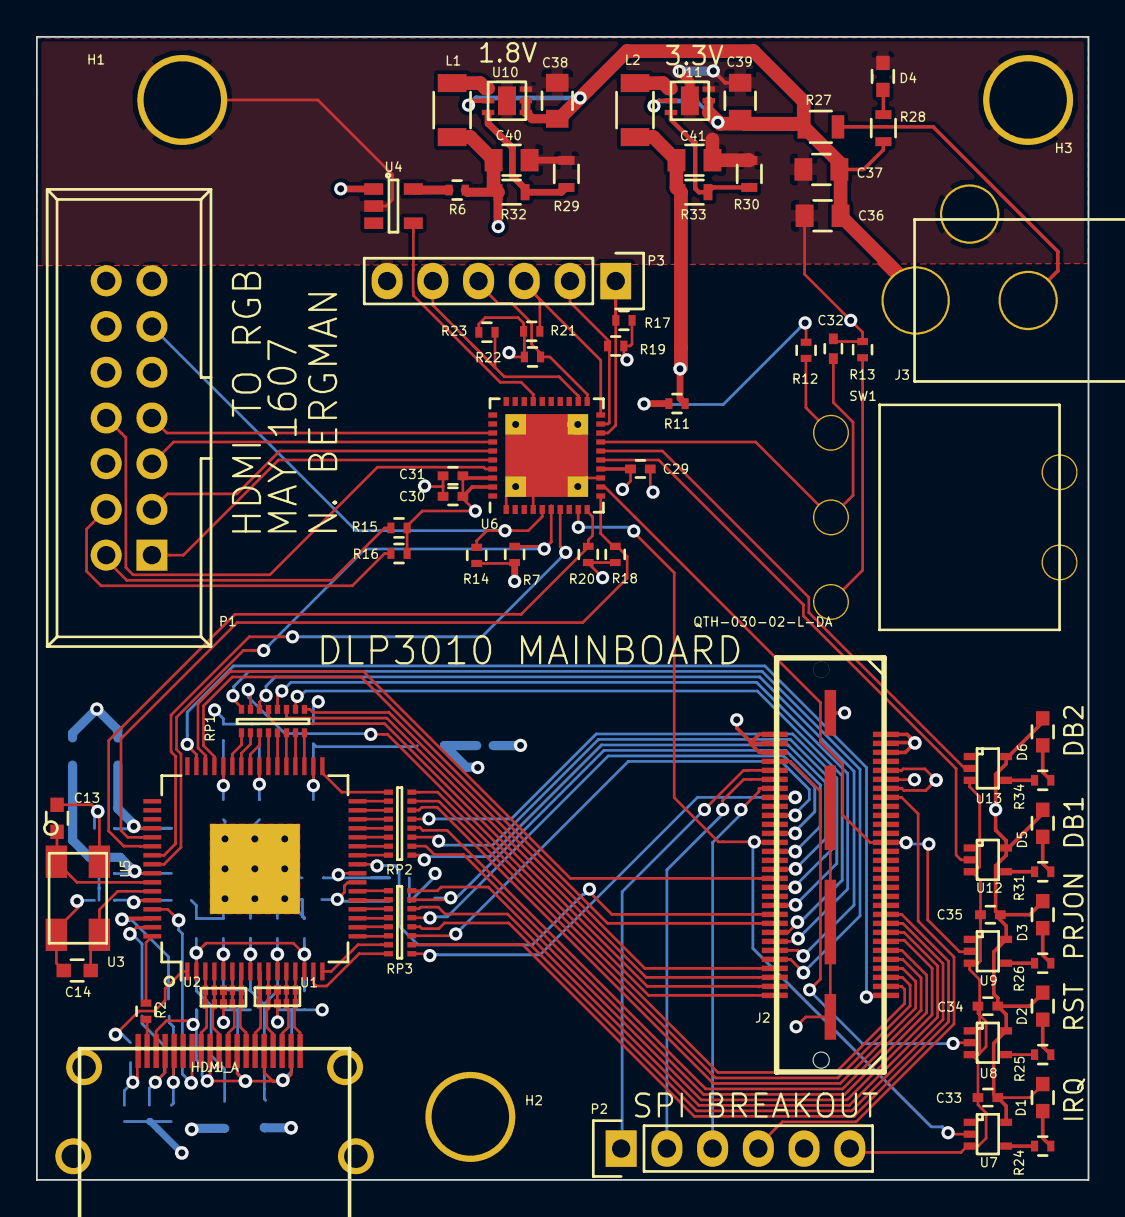
[picture p10: board HDMI2RGB.kicad_pcb from above]

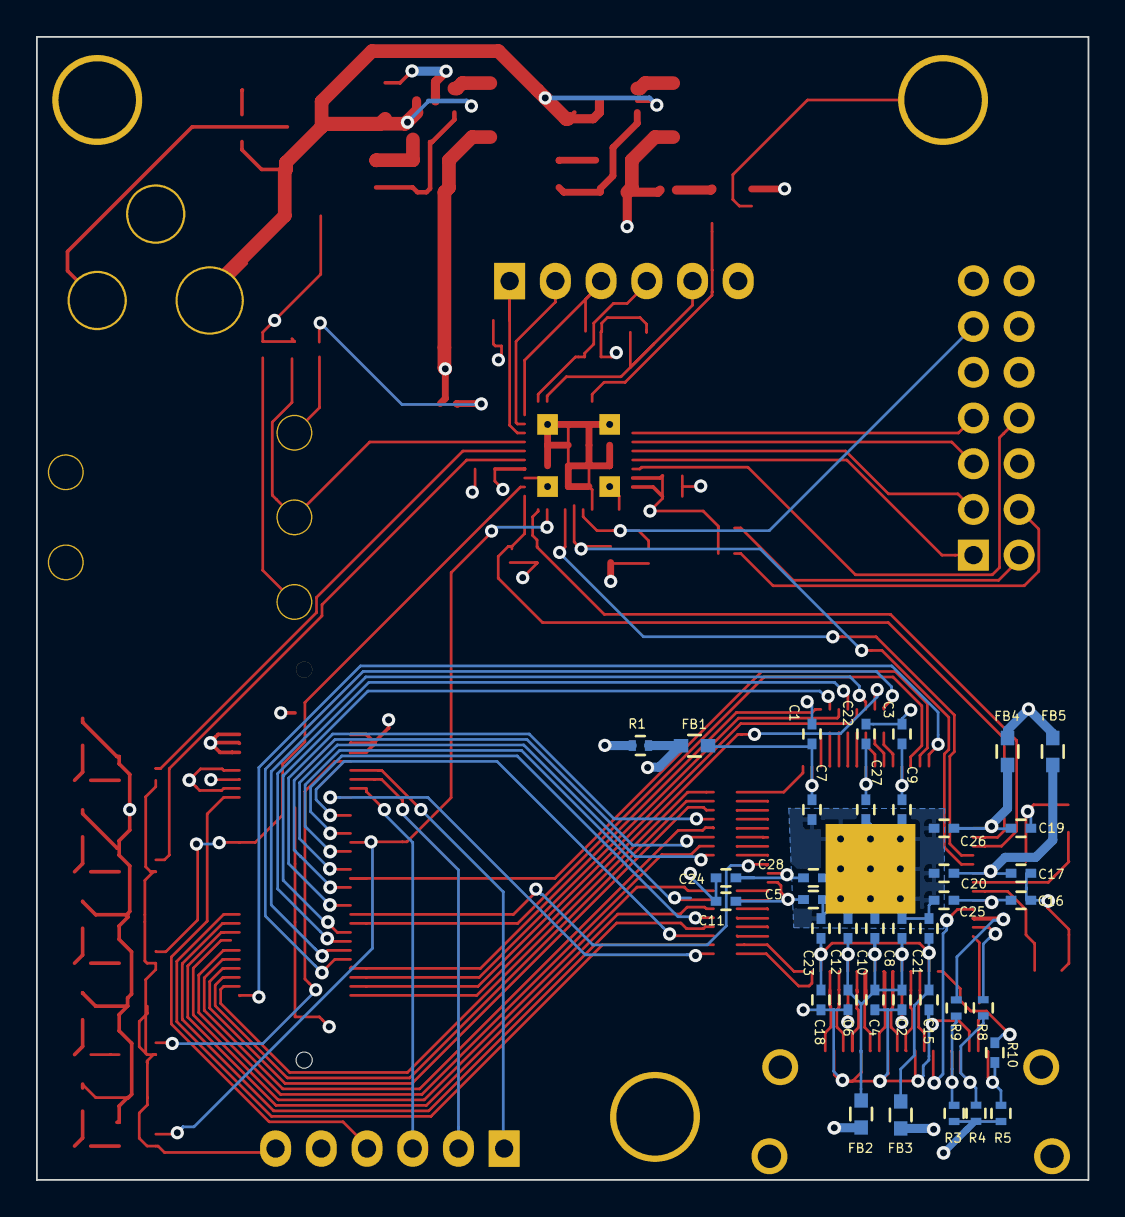
[picture p11: board HDMI2RGB.kicad_pcb from below]

Board: 4 copper layers, 58.4 x 63.5 mm, 114 parts (38 on the bottom side), 130 nets.
