seniorDesignMAY1607/pcb_HDMI2RGB/(commit log)

2016-03-27 Created KiCad project
2016-03-27 HDMI is almost routed, added connector
    [$CONNECTOR.sch, $HDMI_INPUT.sch, CONNECTOR.sch, HDMI2RGB.kicad_pcb, HDMI2RGB.sch, HDMI_INPUT.sch, MSP430.sch, POWER.sch]
2016-03-27 Added pdata lines and ran bus connections
    [$CONNECTOR.sch, $HDMI_INPUT.sch, CONNECTOR.sch, HDMI2RGB.kicad_pcb, HDMI2RGB.sch, HDMI_INPUT.sch, MSP430.sch, POWER.sch]
2016-03-27 Started PCB Layout, added mounting holes, connectors, in correct locations
    [$HDMI_INPUT.sch, $MSP430.sch, CONNECTOR.sch, HDMI2RGB.kicad_pcb, HDMI2RGB.sch, POWER.sch]
2016-03-28 Hdmi and RGB is routed, waiting for trace matching
    [$HDMI_INPUT.sch, $MSP430.sch, HDMI2RGB.kicad_pcb, HDMI_INPUT.sch, MSP430.sch]
2016-03-30 ADV7611 power caps are placed and routed
    [HDMI2RGB.kicad_pcb]
2016-03-30 Basic layout of all components on PCB
    [CONNECTOR.sch, HDMI2RGB.kicad_pcb, HDMI_INPUT.sch, MSP430.sch, POWER.sch]
2016-03-30 Routing power, changed buttons connections, and a few pther connections
    [HDMI2RGB.kicad_pcb, HDMI_INPUT.sch, MSP430.sch]
2016-03-31 First Final -- Waiting for Checker
    [CONNECTOR.sch, HDMI2RGB.kicad_pcb, MSP430.sch, POWER.sch]
2016-03-31 Schematic PDF
2016-03-31 Schematic Titles
    [CONNECTOR.sch, HDMI_INPUT.sch, MSP430.sch, POWER.sch]
2016-03-31 Adjusted all RefDes
    [HDMI2RGB.kicad_pcb]
2016-03-31 New Schematic PDF
2016-03-31 Added silkscreen labels and title to PCB
    [HDMI2RGB.kicad_pcb]
2016-03-31 Changed via size to 23mil diameter
    [HDMI2RGB.kicad_pcb]
2016-03-31 Added BOM
2016-04-01 Changed BOM for several components
    [HDMI_INPUT.sch, MSP430.sch]
2016-04-07 New Schematic PDF and BOM
    [HDMI2RGB-B_Cu.gbr, HDMI2RGB-B_Mask.gbr, HDMI2RGB-B_SilkS.gbr, HDMI2RGB-Edge_Cuts.gbr, HDMI2RGB-F_Cu.gbr, HDMI2RGB-F_Mask.gbr, HDMI2RGB-In1_Cu.gbr, HDMI2RGB-In2_Cu.gbr]
2016-04-07 Re-Plotted Schematic
